Andreani24/ePATH-Test-Bench/img/Assembly.png

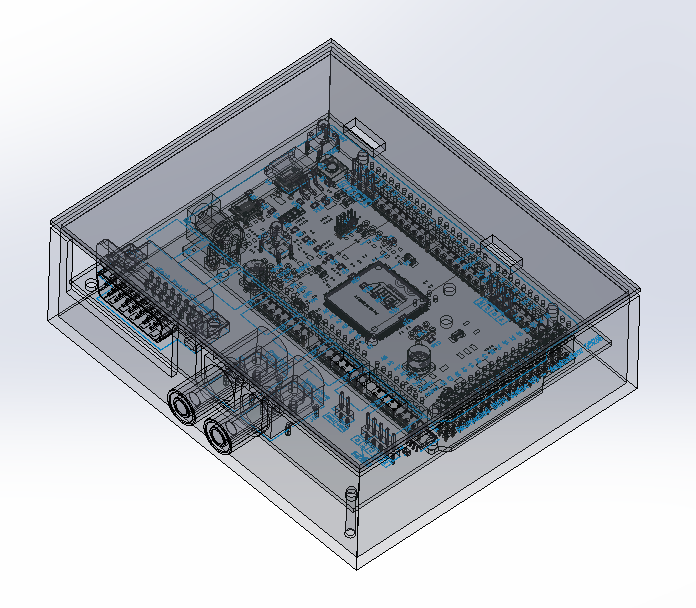
img/Assembly.png
