Andreani24/ePATH-Test-Bench/img/RS232_connector.jpeg

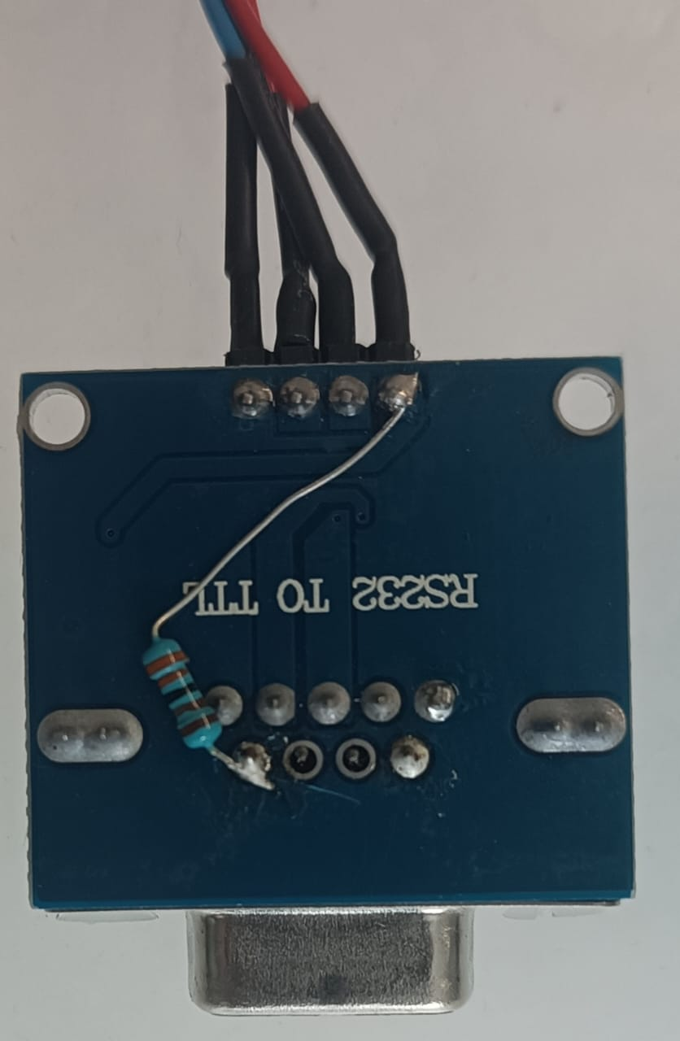
img/RS232_connector.jpeg
