Andreani24/ePATH-Test-Bench/main.tex

\documentclass[10pt]{scrartcl}  % single column, larger font
\usepackage[a4paper,width=170mm,top=25mm,bottom=25mm,bindingoffset=3mm]{geometry}
\setlength{\parskip}{1em}
\usepackage[colorlinks=true, linkcolor=blue, citecolor=blue, urlcolor=blue]{hyperref}
\usepackage{hyperref}
\usepackage[backend=biber,style=numeric,sorting=none]{biblatex}
\addbibresource{references.bib}
\usepackage{lipsum}
\usepackage{graphicx} 
\usepackage{url} 
\usepackage{lipsum} 
\usepackage{float}
\usepackage{amsmath}
\usepackage{subcaption}
\usepackage{mwe}
\usepackage{multicol}
\usepackage{comment}

\renewenvironment{abstract}
 {\quotation\large\noindent\rule{\linewidth}{.5pt}\par\smallskip
  {\centering\bfseries\abstractname\par}\medskip}
 {\par\noindent\rule{\linewidth}{.5pt}\endquotation}

\begin{document}

\renewcommand{\refname}{References}

\title{Development of ePATH Test Bench and Supporting Tools}
\author{Andreani Kalatha}
\maketitle

\begin{abstract}
This report provides a summary of the projects completed over the course of my internship. My primary assignment focused on the development of the ePATH Test Bench, an automated testing software that verifies the functionality of the ePATH board. After overcoming challenges arising with the multimeter communication, I designed three PCB boards compatible with the Arduino DUE, with the third design demonstrating reliable performance. I also developed a graphical user interface to facilitate test execution and designed a custom casing to house the PCB. In addition to the main project, I worked on several smaller initiatives. These included creating an interface to save serial monitor data to a text file, researching electrical switching methods to alternate between ePATH displays, and developing an assessment method to evaluate the accuracy of catheter alignment.
\end{abstract}

\newpage
\tableofcontents 
\newpage % Starts the content on a new page

\input{tex/introduction.tex} 
\input{tex/ePATH_Test_Bench}
\input{tex/Extra_projects}
\input{tex/conclusion.tex}
\printbibliography[heading=bibintoc]
\end{document}
