Andreani24/ePATH-Test-Bench/img/Correct_Relay.png

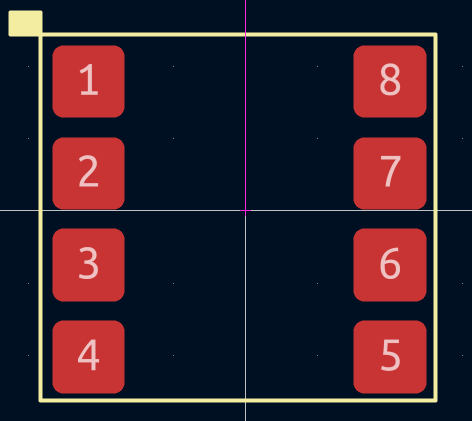
img/Correct_Relay.png
