Andreani24/ePATH-Test-Bench/img/Design1.png

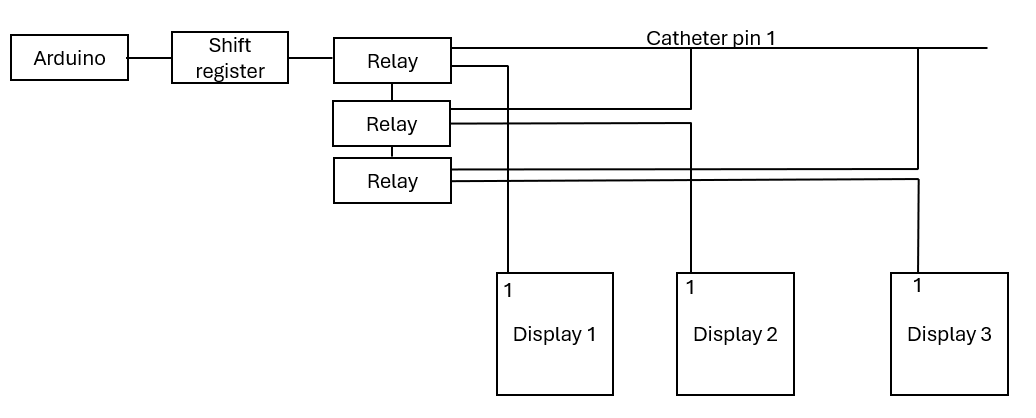
img/Design1.png
