Andreani24/ePATH-Test-Bench/img/Design2.png

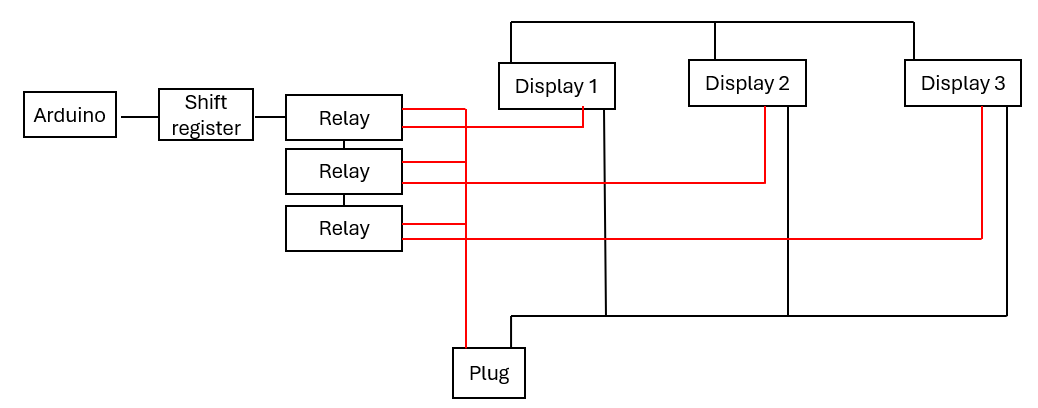
img/Design2.png
