Andreani24/ePATH-Test-Bench/img/General end goal diagram.png

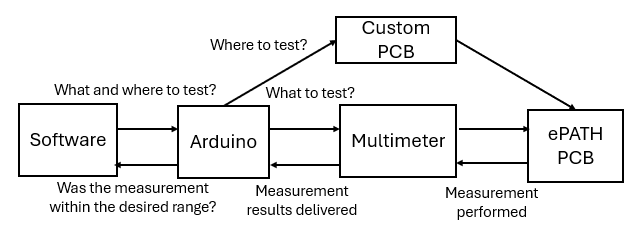
img/General end goal diagram.png
