Andreani24/ePATH-Test-Bench/img/MAX3232_connection.png

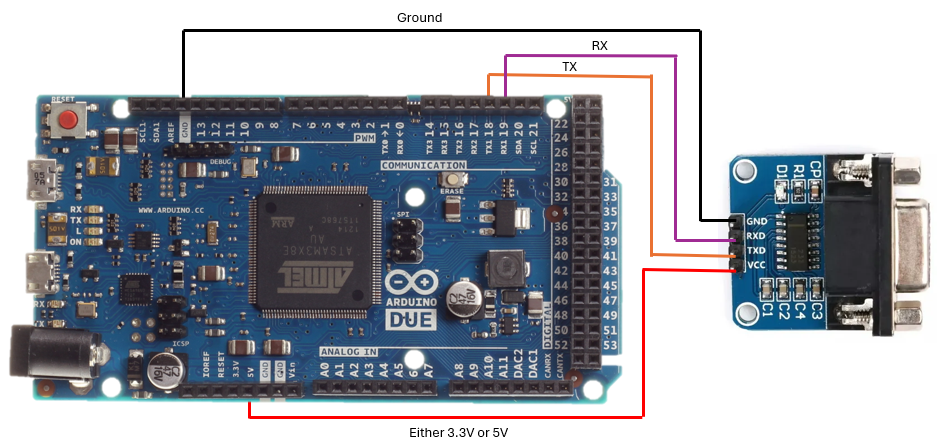
img/MAX3232_connection.png
