Andreani24/ePATH-Test-Bench/Resourses/TheBox.SLDPRT

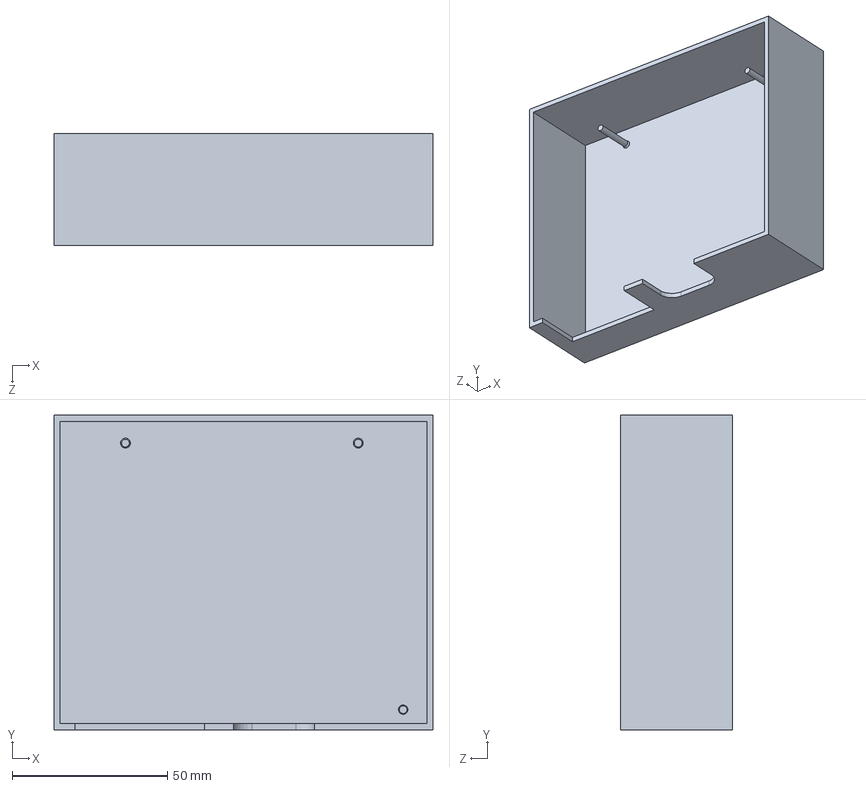
[picture p8: CAD file, 2025-09-16]
Resourses/TheBox.SLDPRT
122.0 x 101.3 x 36.0 mm
