Andreani24/ePATH-Test-Bench/Resourses/TheLid.SLDPRT

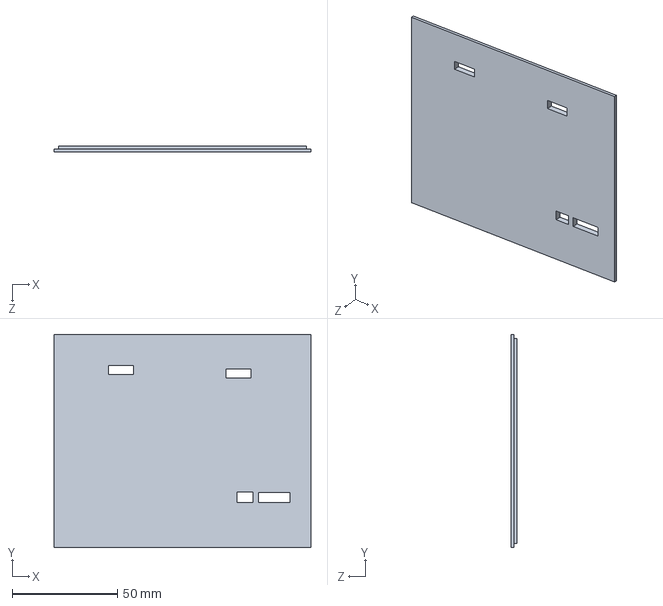
[picture p9: CAD file, 2025-09-16]
Resourses/TheLid.SLDPRT
122.0 x 101.3 x 3.00 mm
