Andreani24/ePATH-Test-Bench/Resourses/Assembly2.SLDASM

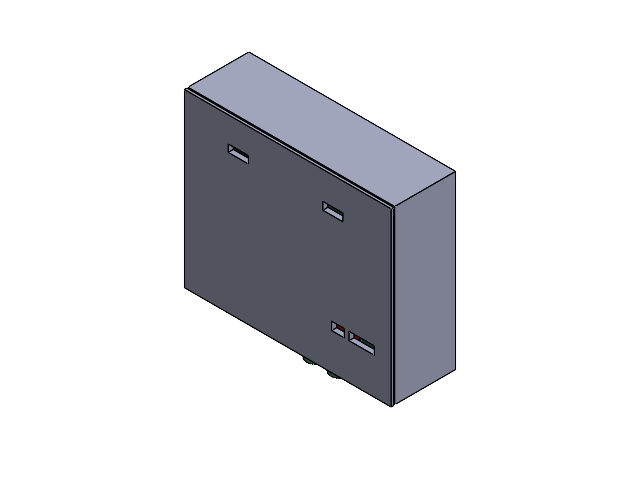
[picture p10: CAD file, 2025-09-16]
Resourses/Assembly2.SLDASM
R_0805_2012Metric_2.step x 19
C_0805_2012Metric_2.step x 5
PinHeader_1x04_P2.54mm_Vertical_2.step x 2
Banana_Cliff_FCR7350R_S16N-PC_Horizontal_2.step x 2
SOIC-8_5.3x5.3mm_P1.27mm_2.step
PinHeader_1x05_P2.54mm_Vertical_2.step
c-2-1825910-2-c-3d_2.step x 2
PinHeader_1x02_P2.54mm_Vertical_2.step
LM1085IS-ADJNOPB_2.step
182-015-113_2.step
PCB attempt 2_silkscreen_2.step
PCB attempt 2_PCB_2.step
PCB - Arduino
MicroUSB B - Hirose - ZX62D-B-5P8
MicroUSB AB - Hirose - ZX62D-AB-5P8
Power Jack - Kycon - KLDHCX-0202-A
LED - Kingbright - KPT-3216EC x 4
Microchip - Atmel - SAM3X8EAU
Berg Header - 1.27 x 10
Berg Header Receptacle 2.54 x 8 - FCI - 66951-008LF x 5
Berg Header Receptacle 2.54 x 10 - FCI - 66951-010LF
Berg Header Receptacle 2.54 x 36 - FCI - 66953-018LF
Capacitor x 9
Capacitor - Nichicon - UUR1C101MCL1GS x 2
Switch - ESwitch - TLE3303
Part25^ARDUINO DUE (1)
TheBox
TheLid
