Andreani24/ePATH-Test-Bench/img/Assembly1.png

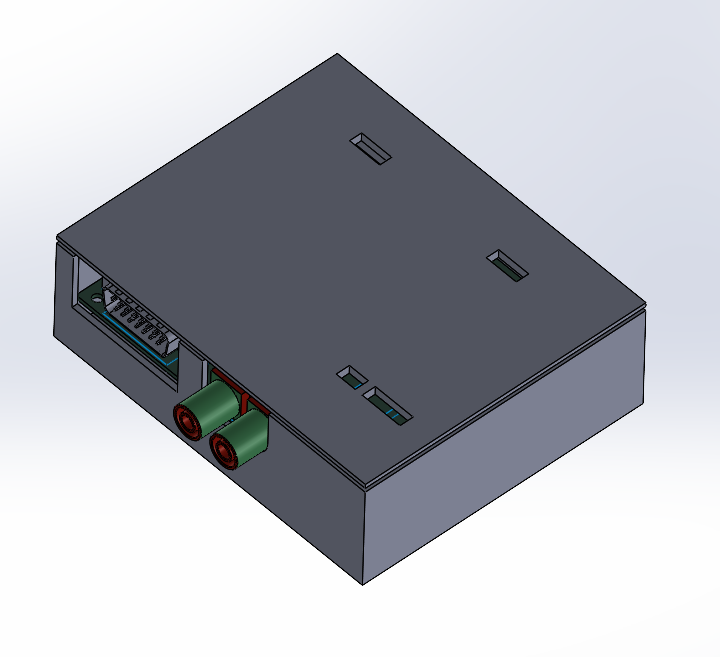
img/Assembly1.png
