Andreani24/ePATH-Test-Bench/img/button_wiring.png

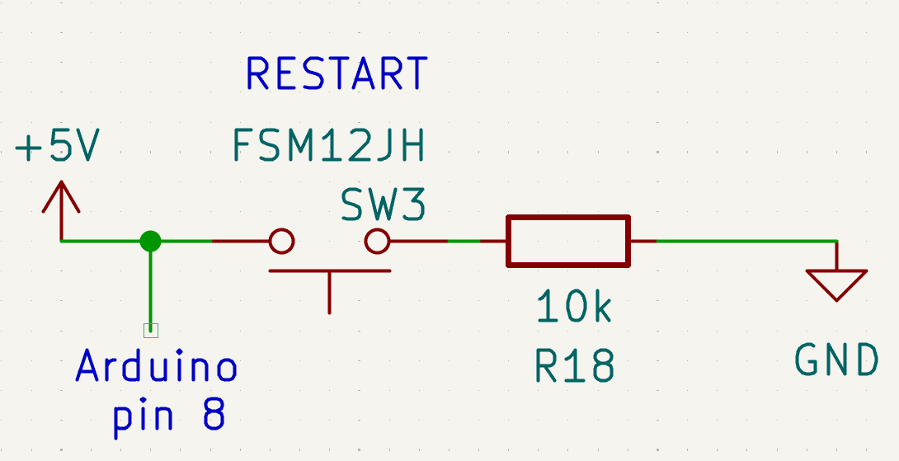
img/button_wiring.png
