Andreani24/ePATH-Test-Bench/(commit log)

2025-08-04 Updates from Overleaf
    [Shift registers sim.brd]
2025-09-09 Latest version
    [Shift register bytes.xlsx, Shift registers sim (1).brd]
